Arghyoo0/esp32-submersible-pump-automation/(notices)

Notices in the files:
README.md:
License: MIT
